LiamLIMB/Knightsaurus2026/Knightsaurus Engineering Design Sketches/circuit diagram.png

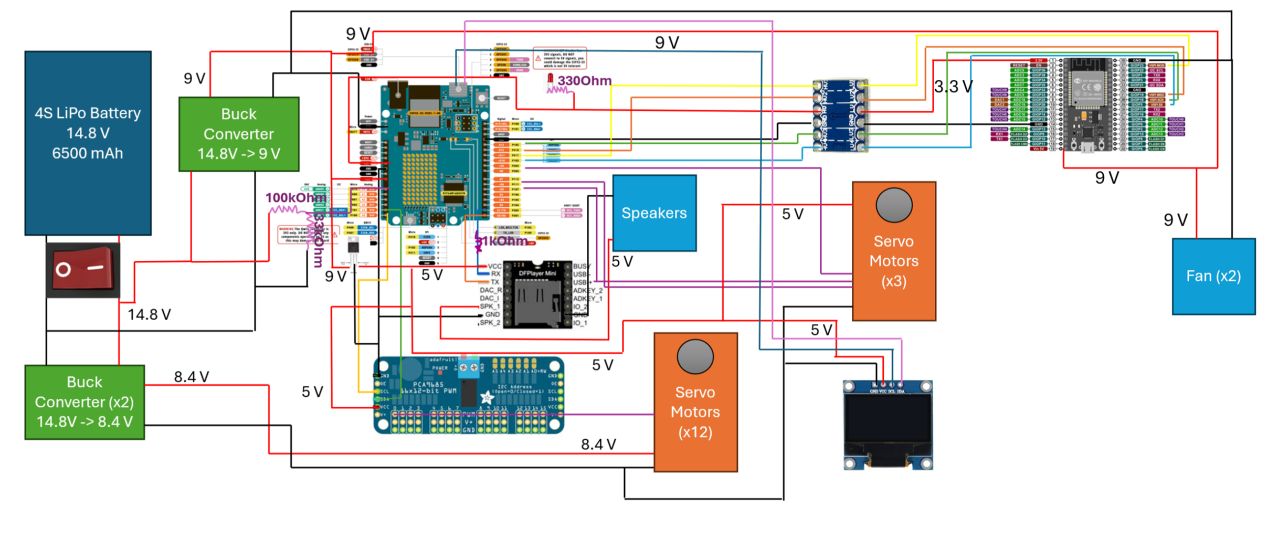
Knightsaurus Engineering Design Sketches/circuit diagram.png
