LiamLIMB/Knightsaurus2026/Knightsaurus Team Photo 2.png

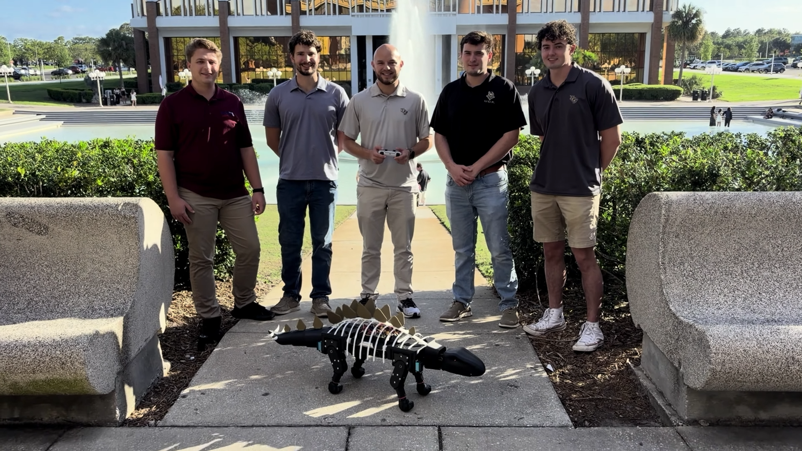
Knightsaurus Team Photo 2.png
