LiamLIMB/Knightsaurus2026/README.md

# Knightsaurus2026
Knightsaurus is a quadrupedal (four-legged) robotic Stegosaurus including a modular design and Bluetooth remote control functionality. Lightweight and affordable design (&lt; $700). Features walking, a moving head, a moving tail, and sound effects.  Sleek black and gold design showcasing UCF spirit.
