LiamLIMB/Knightsaurus2026/Knightsaurus Engineering Design Sketches/Chassis CAD sketch.png

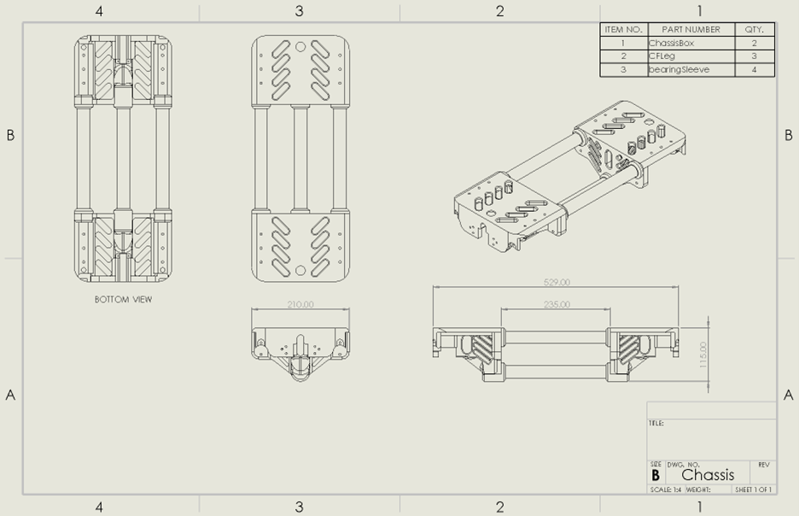
Knightsaurus Engineering Design Sketches/Chassis CAD sketch.png
