LiamLIMB/Knightsaurus2026/Knightsaurus Engineering Design Sketches/code block diagram.png

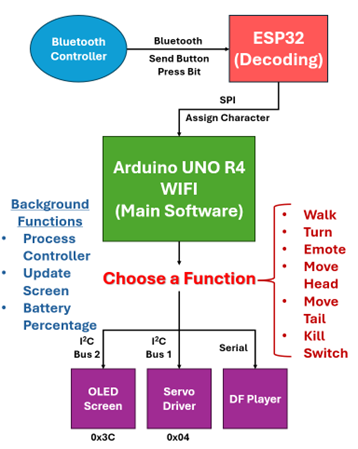
Knightsaurus Engineering Design Sketches/code block diagram.png
