LiamLIMB/Knightsaurus2026/Knightsaurus Engineering Design Sketches/controller layout.png

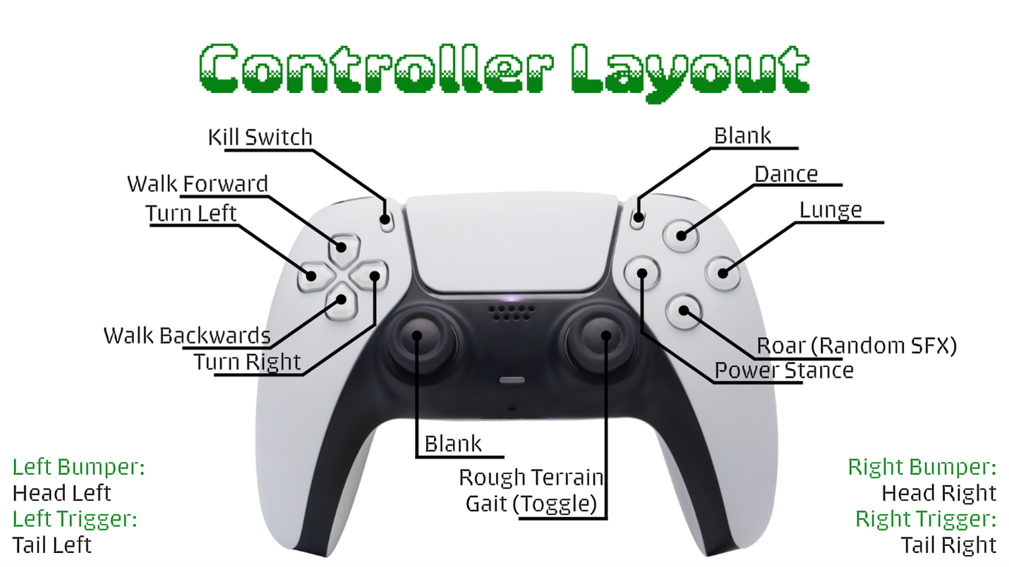
Knightsaurus Engineering Design Sketches/controller layout.png
