LiamLIMB/Knightsaurus2026/Knightsaurus Engineering Design Sketches/Electronics Box CAD sketch.png

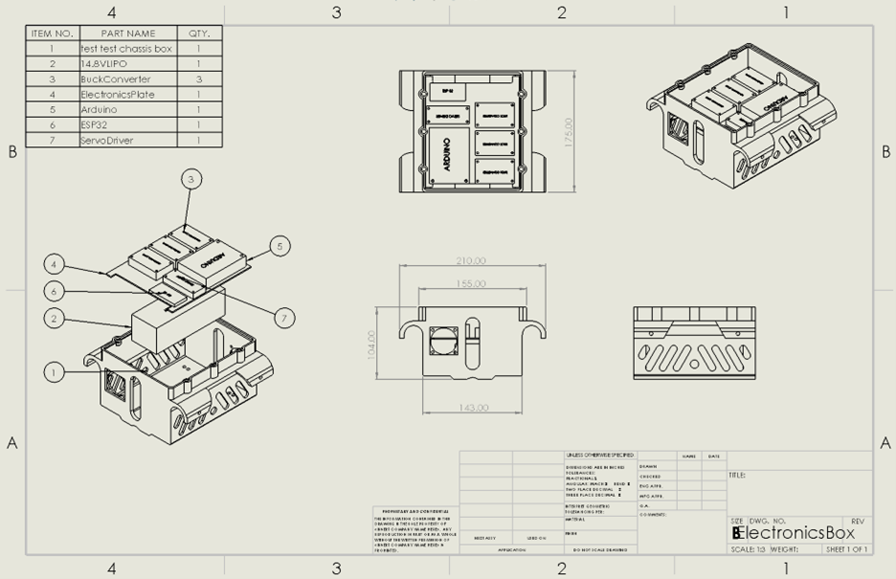
Knightsaurus Engineering Design Sketches/Electronics Box CAD sketch.png
