LiamLIMB/Knightsaurus2026/Knightsaurus Engineering Design Sketches/Full CAD model exploded.png

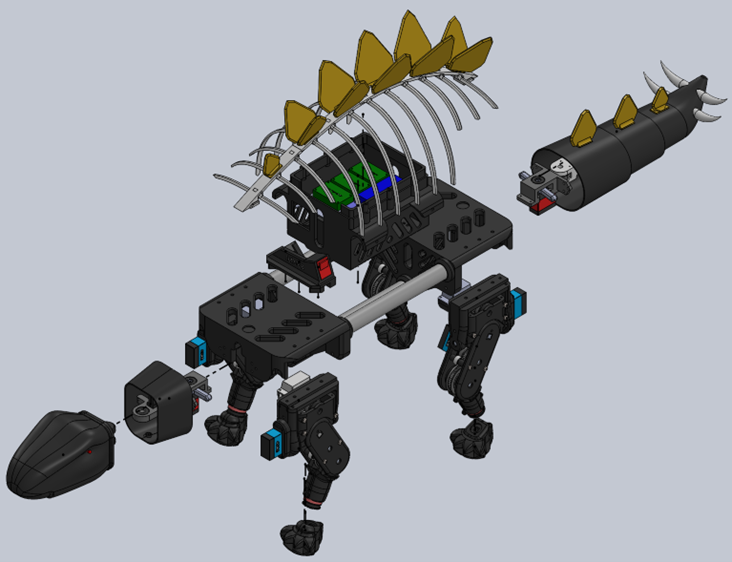
Knightsaurus Engineering Design Sketches/Full CAD model exploded.png
