LiamLIMB/Knightsaurus2026/Knightsaurus Engineering Design Sketches/Full CAD model sketch.png

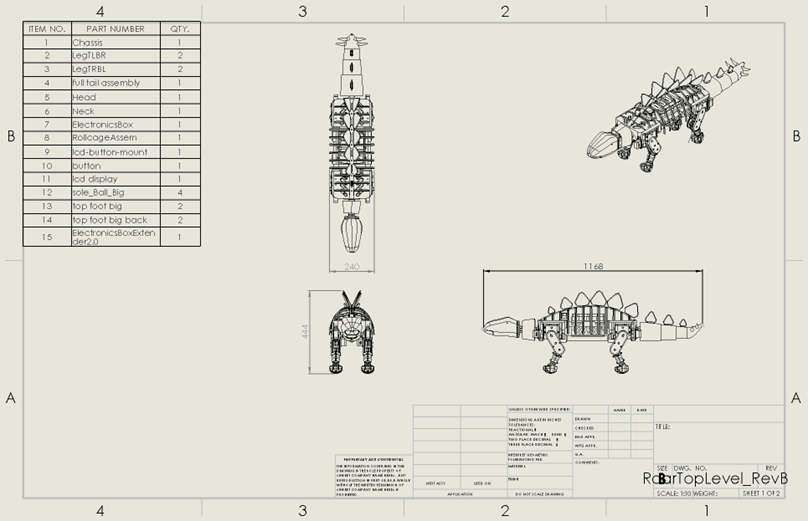
Knightsaurus Engineering Design Sketches/Full CAD model sketch.png
