LiamLIMB/Knightsaurus2026/Knightsaurus Engineering Design Sketches/Full CAD model.png

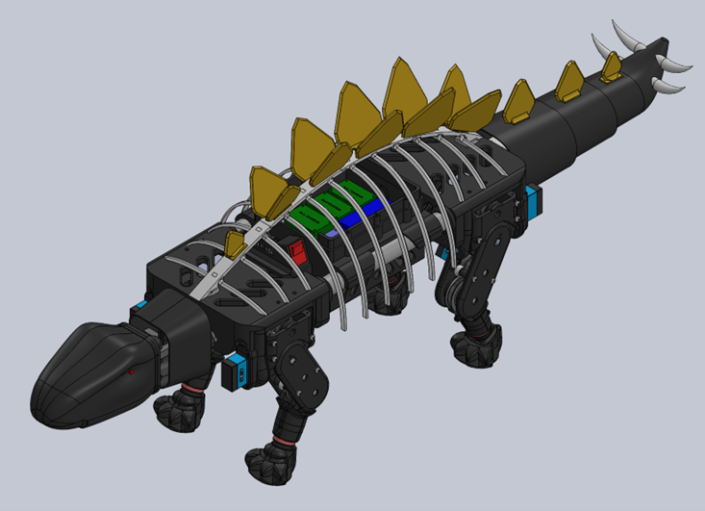
Knightsaurus Engineering Design Sketches/Full CAD model.png
