LiamLIMB/Knightsaurus2026/Knightsaurus Engineering Design Sketches/Head CAD exploded sketch.png

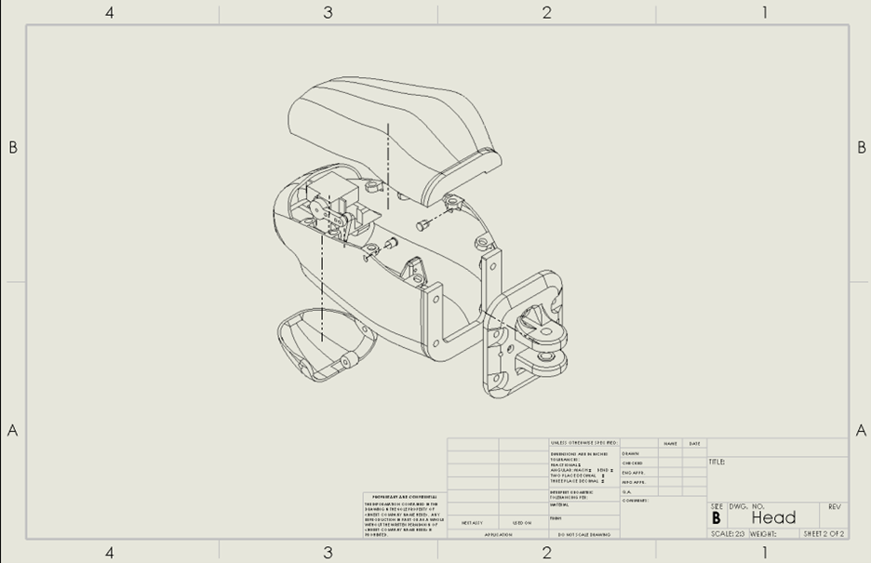
Knightsaurus Engineering Design Sketches/Head CAD exploded sketch.png
