LiamLIMB/Knightsaurus2026/Knightsaurus Engineering Design Sketches/Head CAD sketch.png

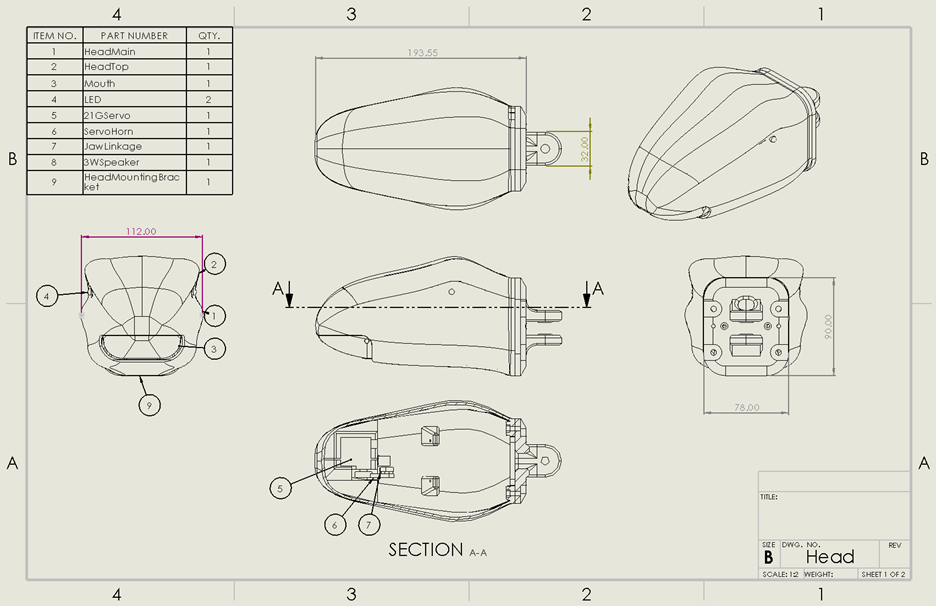
Knightsaurus Engineering Design Sketches/Head CAD sketch.png
