LiamLIMB/Knightsaurus2026/Knightsaurus Engineering Design Sketches/Leg CAD sketch 2.png

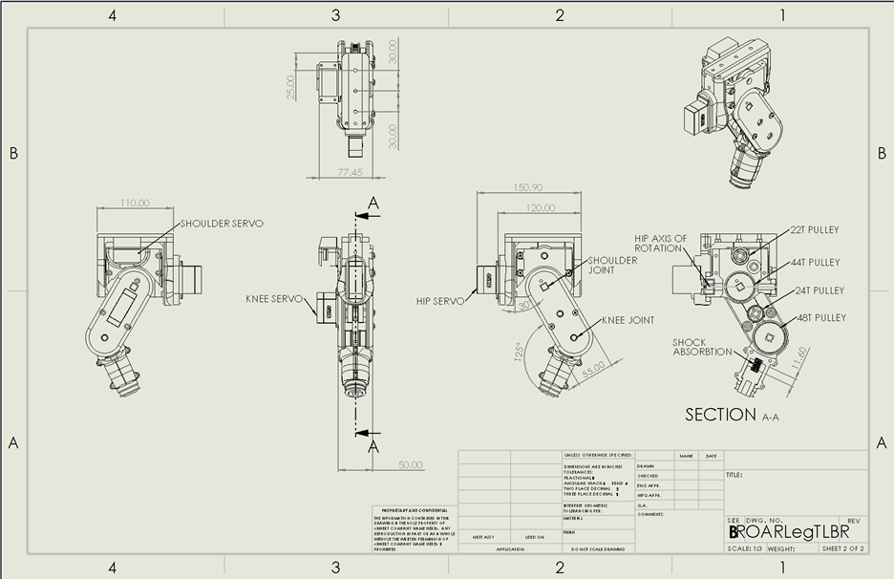
Knightsaurus Engineering Design Sketches/Leg CAD sketch 2.png
