LiamLIMB/Knightsaurus2026/Knightsaurus Engineering Design Sketches/Leg CAD sketch exploded.png

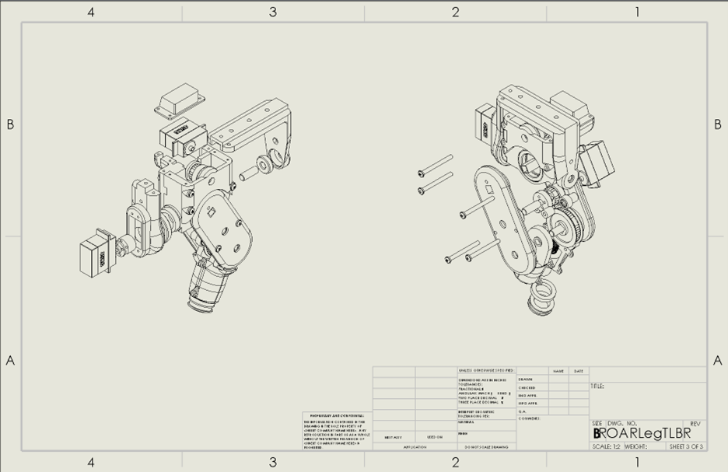
Knightsaurus Engineering Design Sketches/Leg CAD sketch exploded.png
