LiamLIMB/Knightsaurus2026/Knightsaurus Engineering Design Sketches/Leg CAD sketch.png

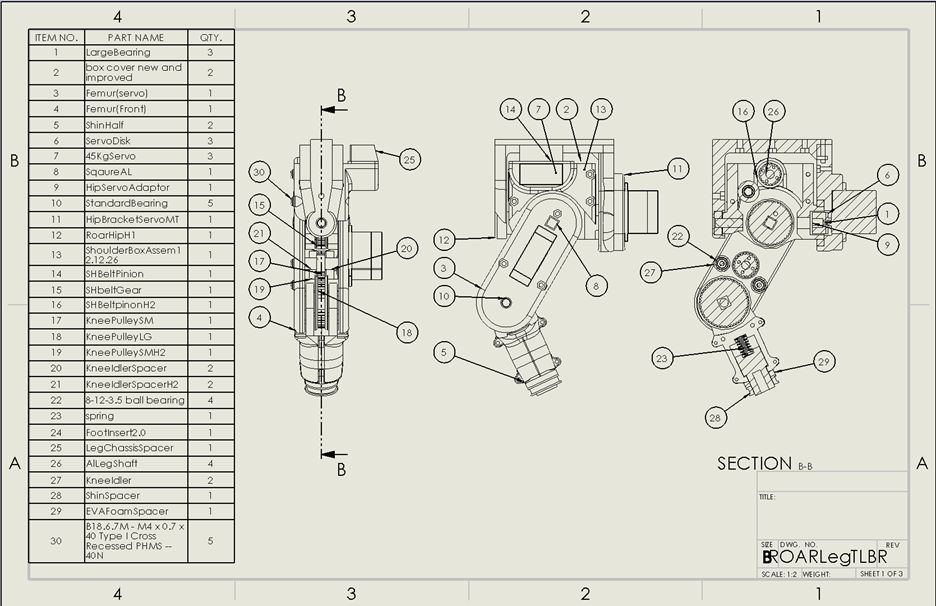
Knightsaurus Engineering Design Sketches/Leg CAD sketch.png
