LiamLIMB/Knightsaurus2026/Knightsaurus Engineering Design Sketches/Neck CAD exploded sketch.png

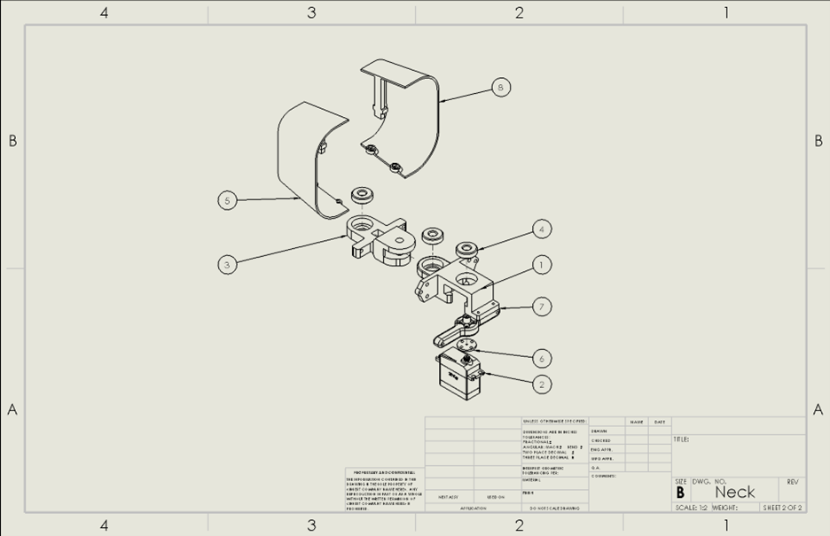
Knightsaurus Engineering Design Sketches/Neck CAD exploded sketch.png
