LiamLIMB/Knightsaurus2026/Knightsaurus Engineering Design Sketches/Neck CAD sketch.png

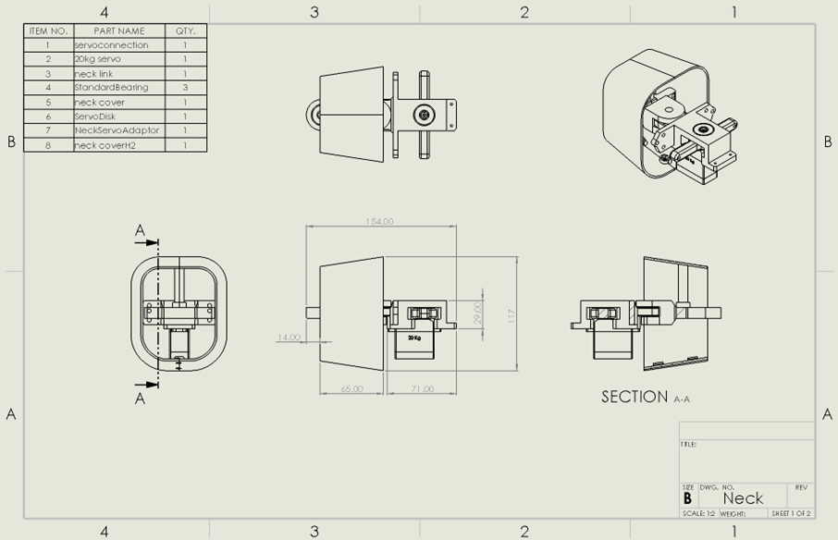
Knightsaurus Engineering Design Sketches/Neck CAD sketch.png
