LiamLIMB/Knightsaurus2026/Knightsaurus Engineering Design Sketches/Roll Cage Sketch.png

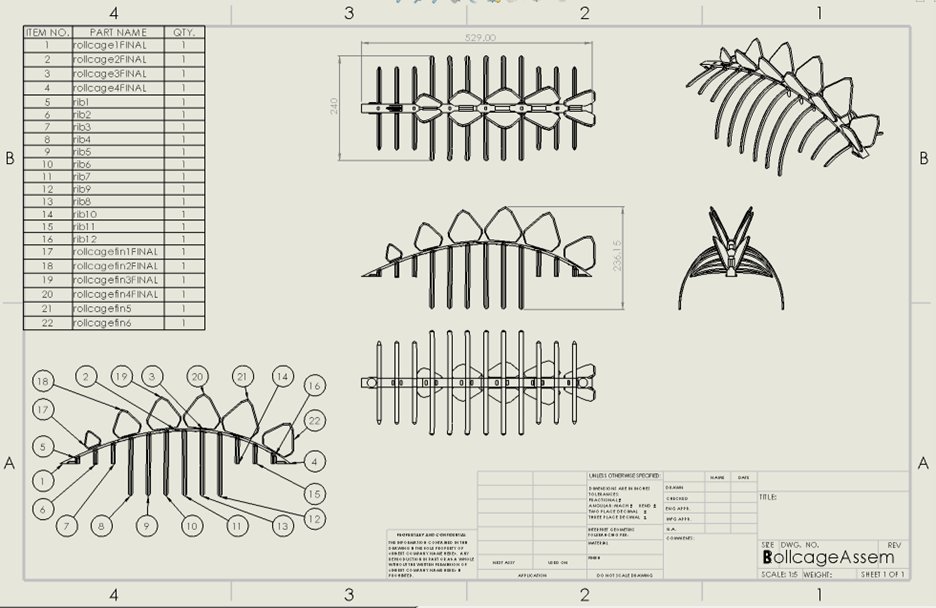
Knightsaurus Engineering Design Sketches/Roll Cage Sketch.png
