LiamLIMB/Knightsaurus2026/Knightsaurus Engineering Design Sketches/Tail CAD exploded sketch.png

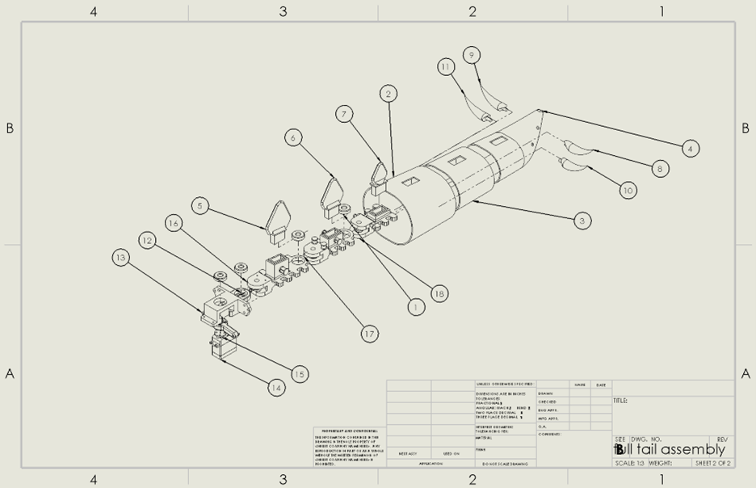
Knightsaurus Engineering Design Sketches/Tail CAD exploded sketch.png
