LiamLIMB/Knightsaurus2026/Knightsaurus Engineering Design Sketches/Tail CAD sketch.png

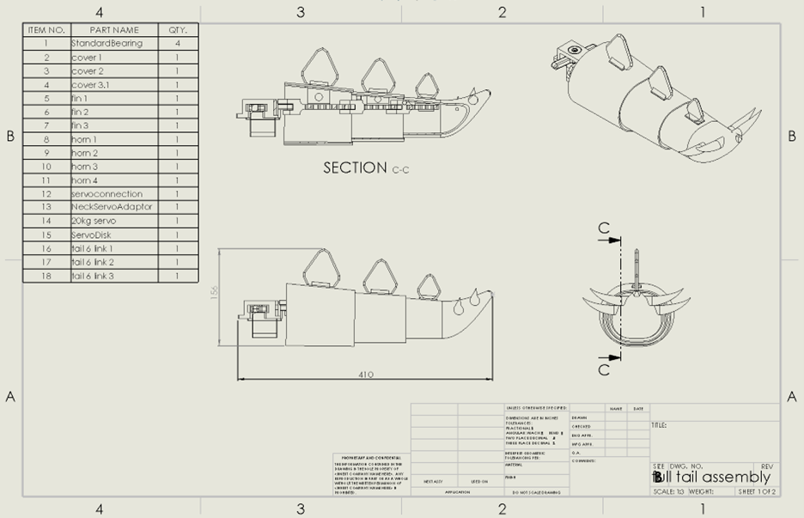
Knightsaurus Engineering Design Sketches/Tail CAD sketch.png
