LiamLIMB/Knightsaurus2026/(commit log)

2026-04-17 Bill of Materials for Knightsaurus (PDF)
2026-04-17 Bill of Materials for Knightsaurus (Excel)
2026-04-23 Added the Main Files for the UNO and ESP32
2026-04-24 Added OLED on Wire1
2026-05-05 Added the Final Kill Switch
